kirby6365/voltra_ring/case/renders/band_plate.png

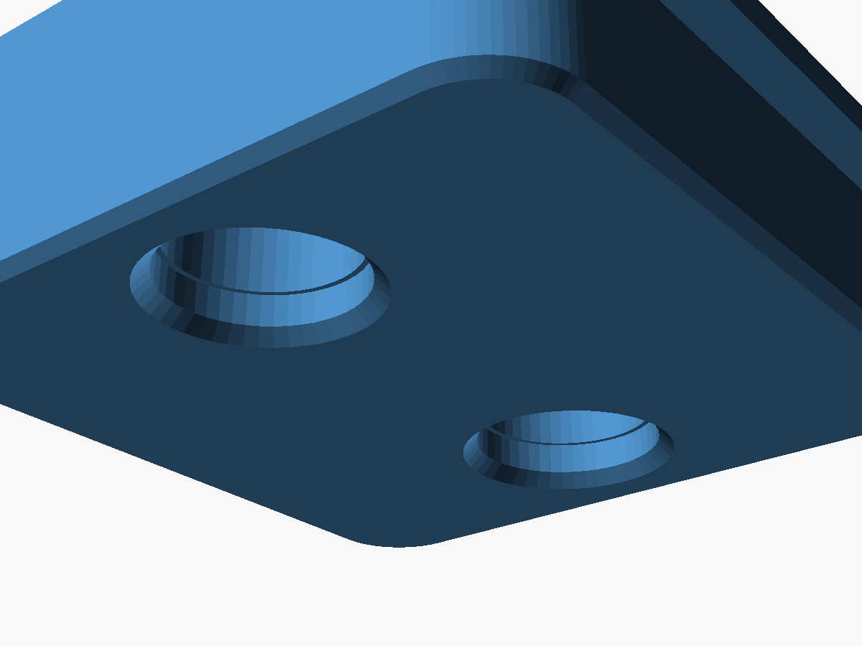
case/renders/band_plate.png
