kirby6365/voltra_ring/case/renders/clip_b_ribs.png

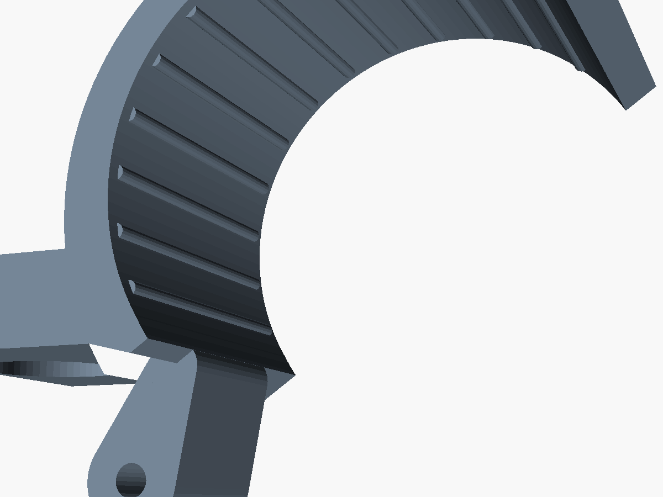
case/renders/clip_b_ribs.png
