kirby6365/voltra_ring/case/renders/clip_tpu_liners.png

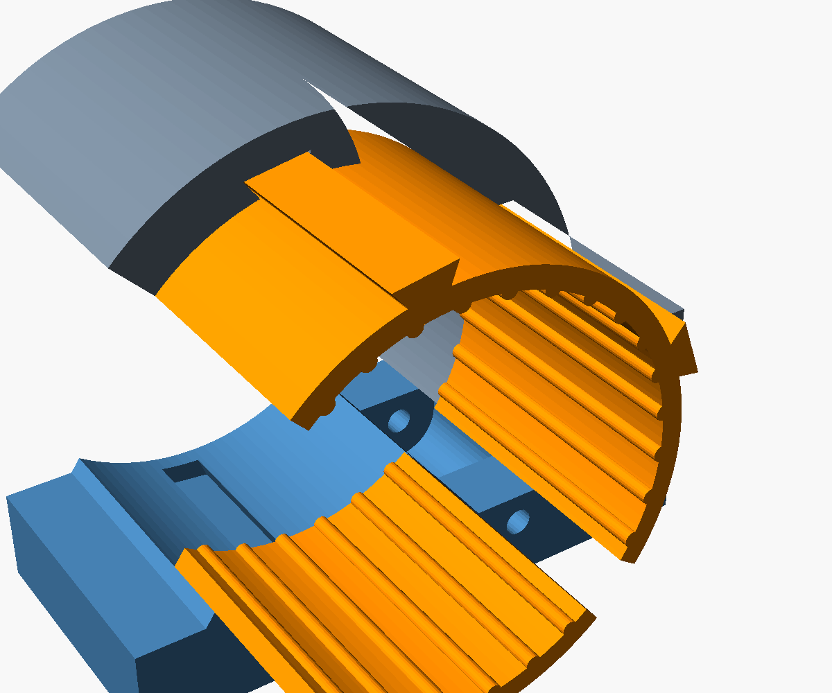
case/renders/clip_tpu_liners.png
