kirby6365/voltra_ring/case/renders/clip_tpu_side.png

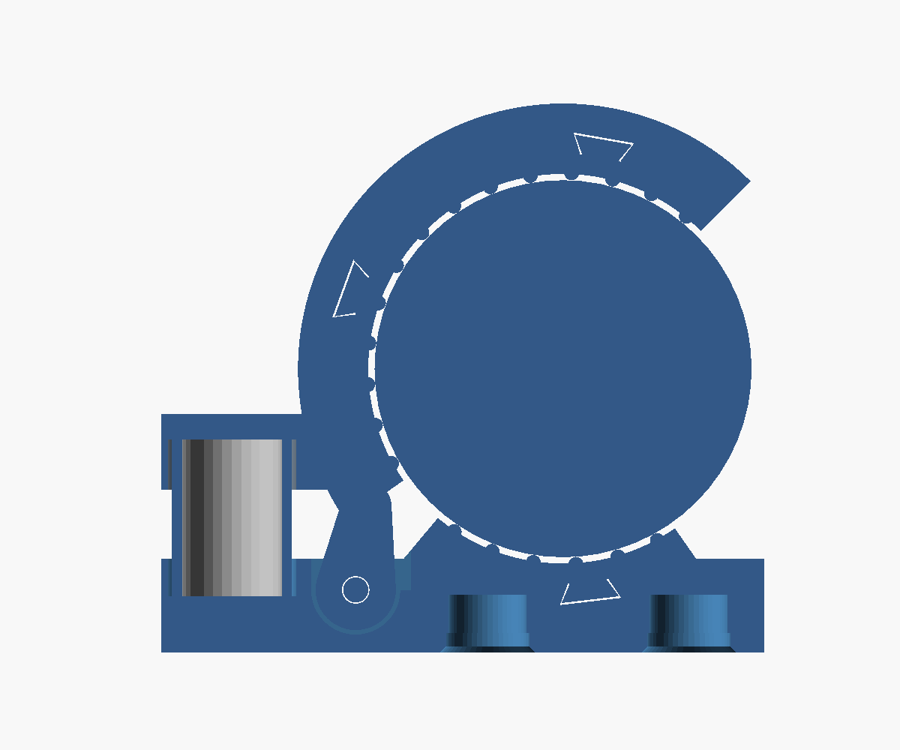
case/renders/clip_tpu_side.png
