kirby6365/voltra_ring/case/renders/clip_upper_jaw.png

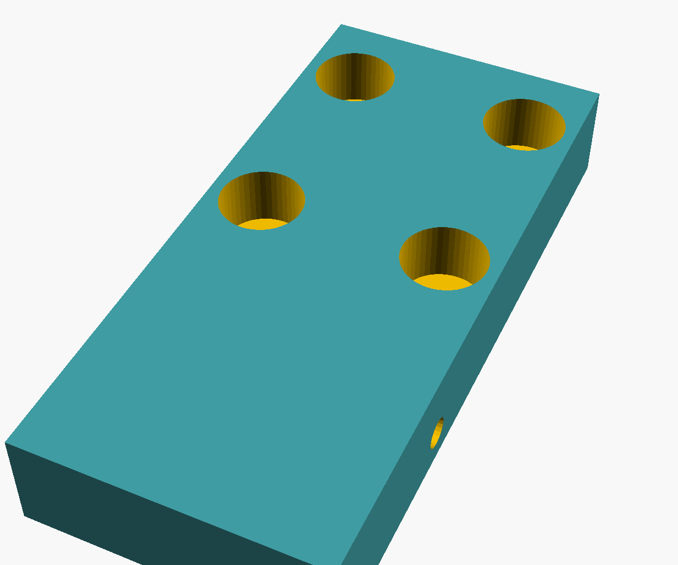
case/renders/clip_upper_jaw.png
