kirby6365/voltra_ring/case/renders/far_corner_closeup.png

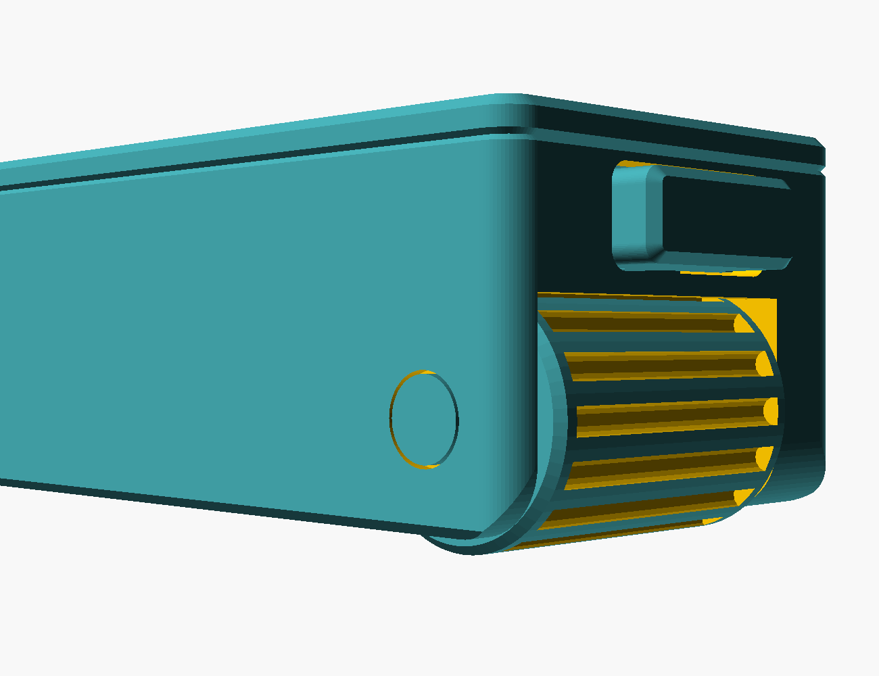
case/renders/far_corner_closeup.png
