kirby6365/voltra_ring/case/renders/lid_outside.png

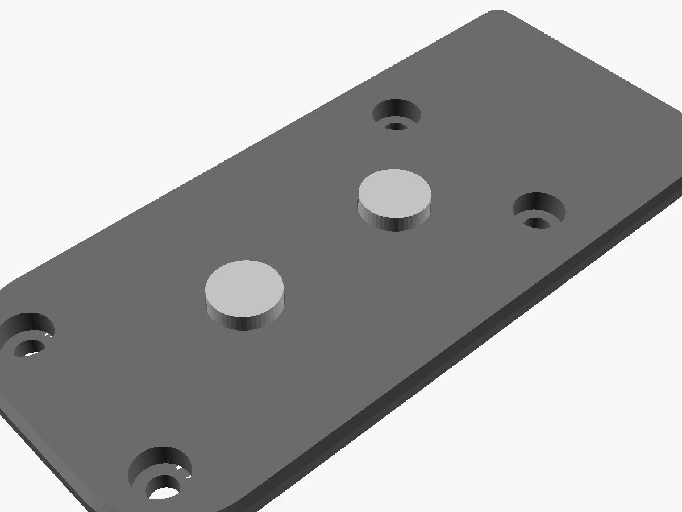
case/renders/lid_outside.png
