kirby6365/voltra_ring/case/renders/mounted_side_view.png

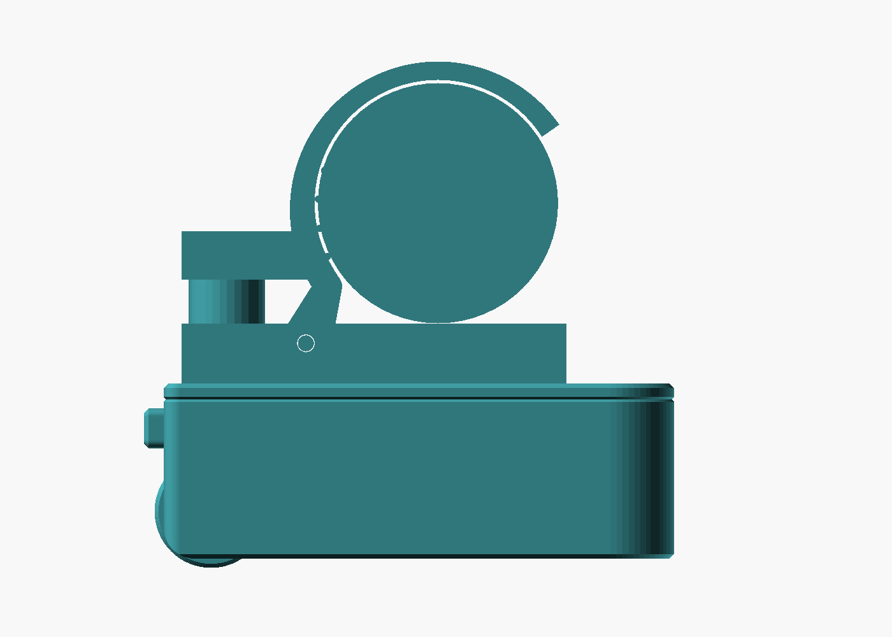
case/renders/mounted_side_view.png
