kirby6365/voltra_ring/case/renders/section.png

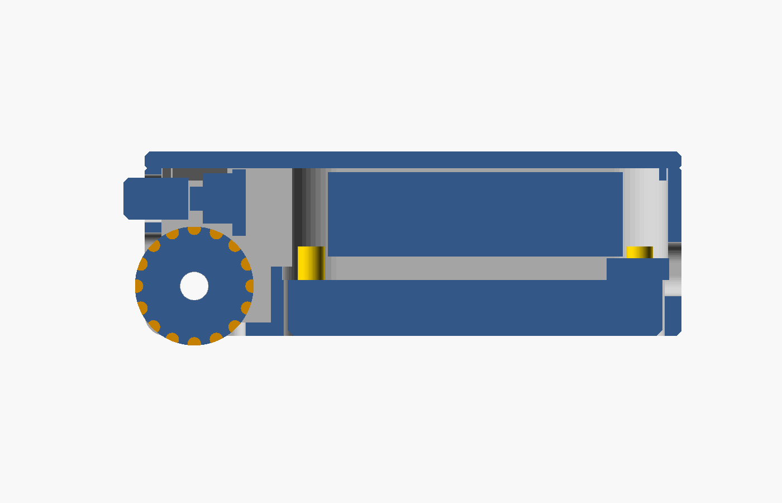
case/renders/section.png
