kirby6365/voltra_ring/case/renders/tub_far_edge.png

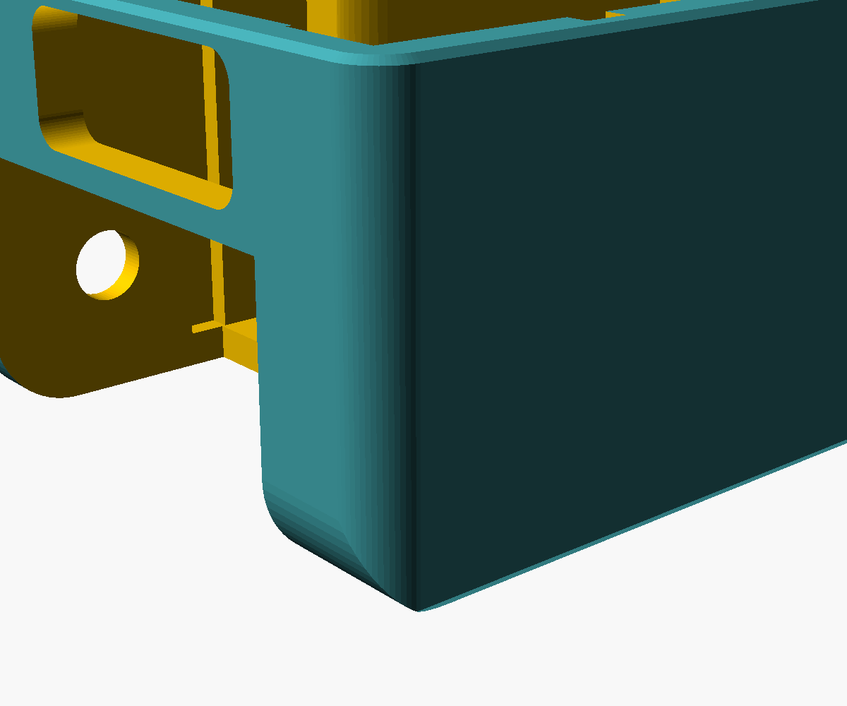
case/renders/tub_far_edge.png
