kirby6365/voltra_ring/case/renders/wheel.png

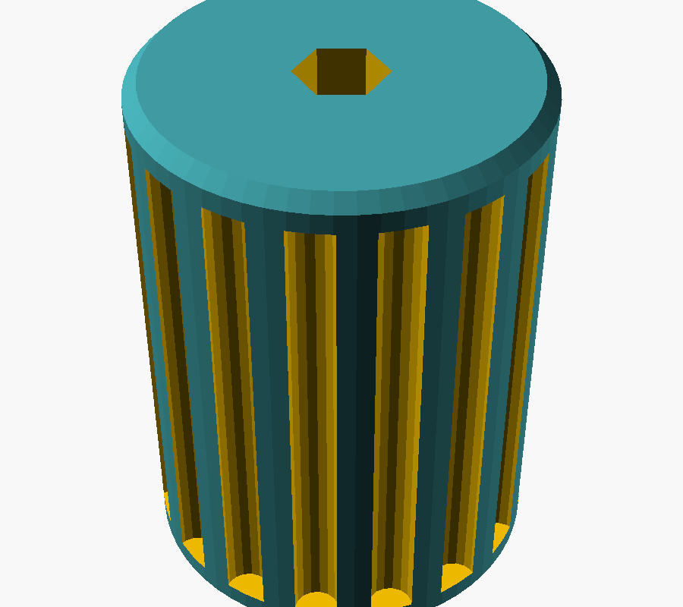
case/renders/wheel.png
