kirby6365/voltra_ring/case/renders/wheel_opening.png

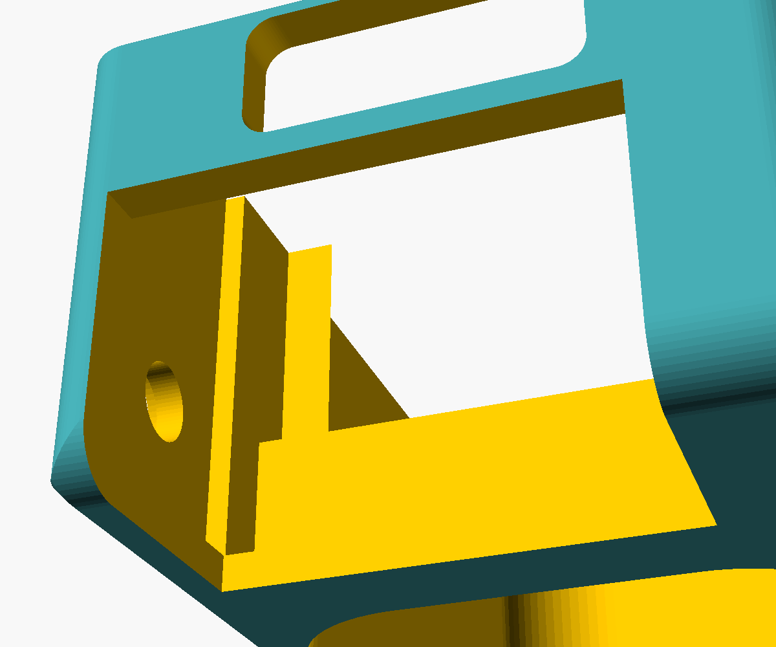
case/renders/wheel_opening.png
