kirby6365/voltra_ring/case/stl/esp32s3_lcd147_clip_b.stl

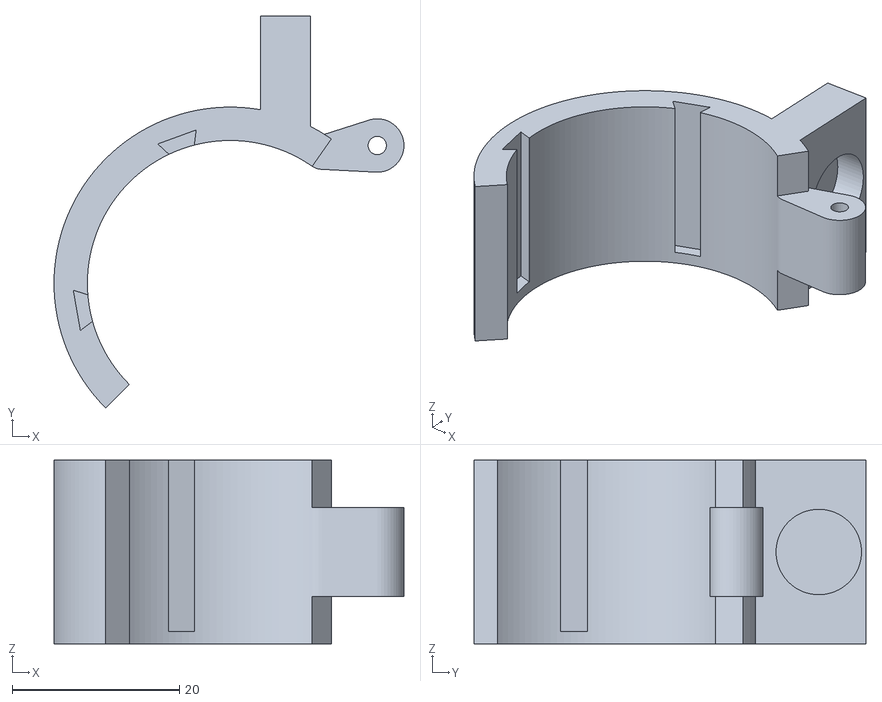
[picture p16: CAD file, 2026-11-13]
case/stl/esp32s3_lcd147_clip_b.stl
41.9 x 46.9 x 22.0
