kirby6365/voltra_ring/case/waveshare_esp32_s3_touch_lcd_1.47.STEP

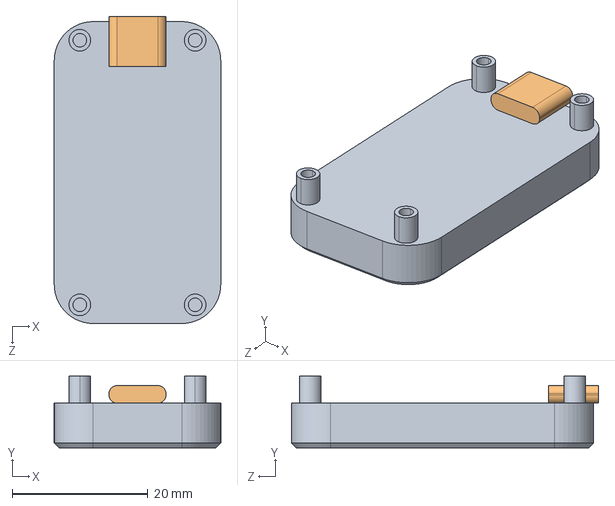
[picture p17: CAD file, 2026-11-13]
case/waveshare_esp32_s3_touch_lcd_1.47.STEP
24.6 x 10.6 x 45.2 mm
