kirby6365/voltra_ring/case/stl/esp32s3_lcd147_liner_a.stl

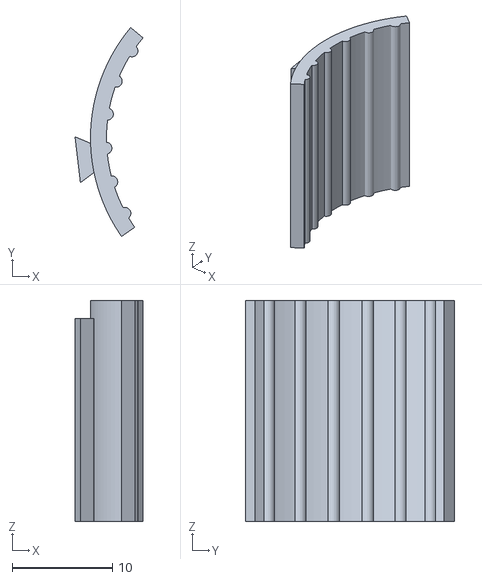
[picture p18: CAD file, 2026-11-13]
case/stl/esp32s3_lcd147_liner_a.stl
6.77 x 20.8 x 22.0
