kirby6365/voltra_ring/case/stl/esp32s3_lcd147_wheel.stl

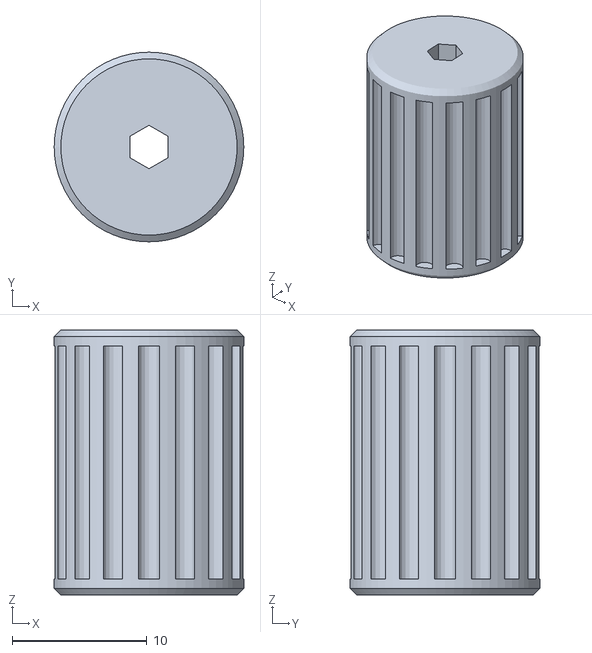
[picture p19: CAD file, 2026-11-13]
case/stl/esp32s3_lcd147_wheel.stl
14.1 x 14.1 x 19.7
