kirby6365/voltra_ring/case/stl/esp32s3_lcd147_band_20.stl

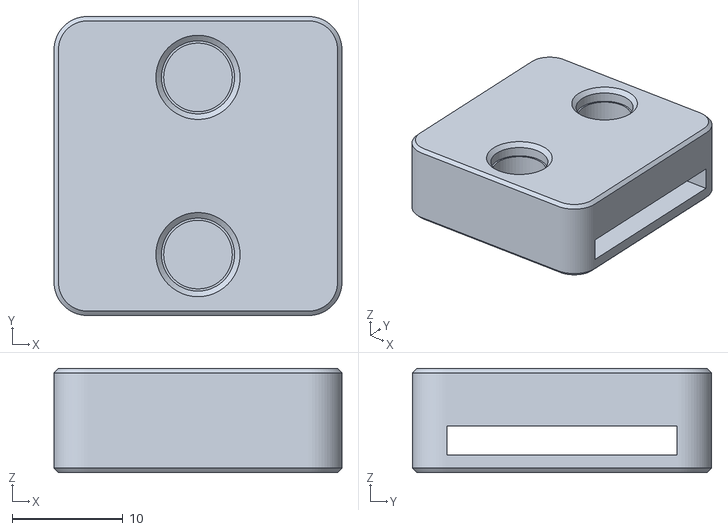
[picture p20: CAD file, 2026-11-13]
case/stl/esp32s3_lcd147_band_20.stl
26.0 x 27.0 x 9.40
