kirby6365/voltra_ring/case/stl/esp32s3_lcd147_fit_test.stl

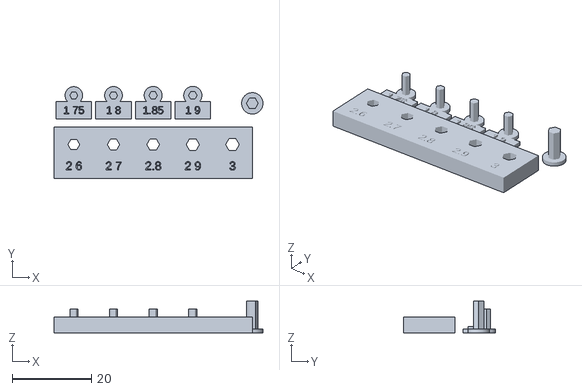
[picture p21: CAD file, 2026-11-13]
case/stl/esp32s3_lcd147_fit_test.stl
52.7 x 23.3 x 8.00
