kirby6365/voltra_ring/case/stl/esp32s3_lcd147_tub.stl

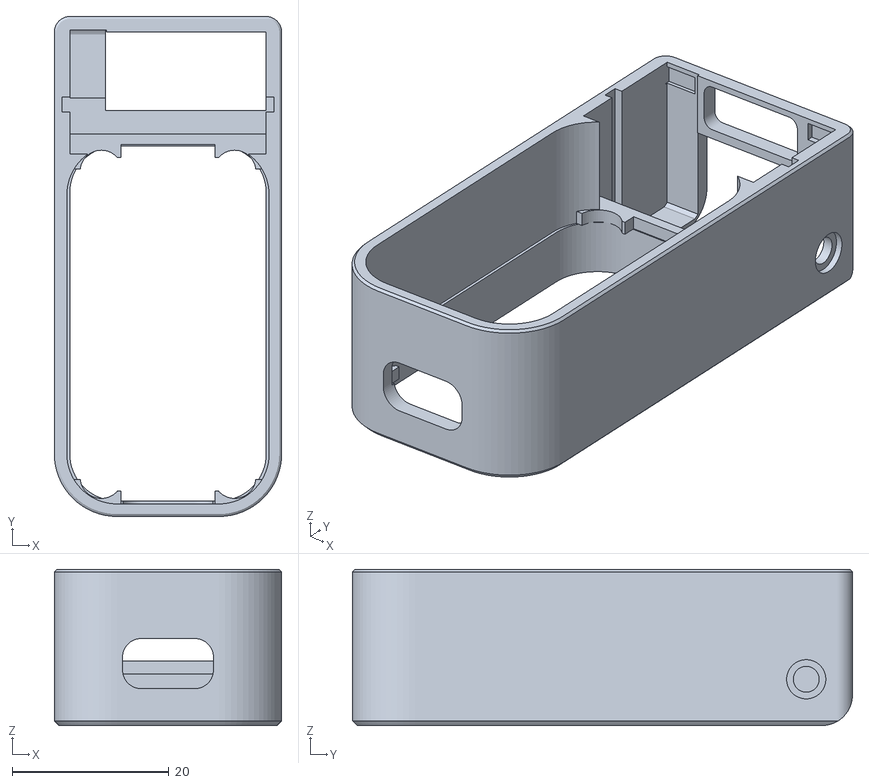
[picture p22: CAD file, 2026-11-13]
case/stl/esp32s3_lcd147_tub.stl
29.0 x 63.8 x 19.9
