kirby6365/voltra_ring/case/stl/esp32s3_lcd147_band_13.stl

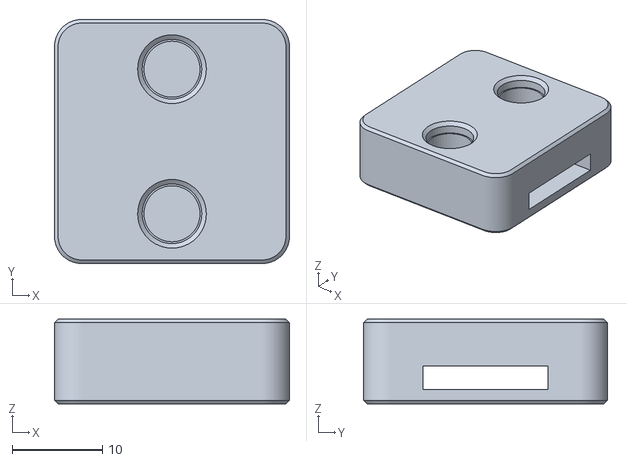
[picture p23: CAD file, 2026-11-13]
case/stl/esp32s3_lcd147_band_13.stl
26.0 x 27.0 x 9.40
