kirby6365/voltra_ring/case/stl/esp32s3_lcd147_shaft.stl

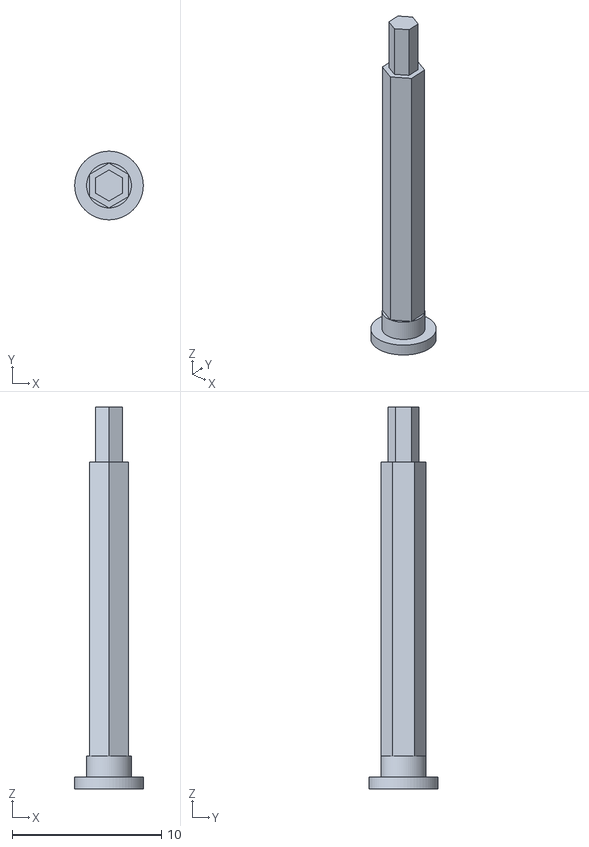
[picture p24: CAD file, 2026-11-13]
case/stl/esp32s3_lcd147_shaft.stl
4.60 x 4.60 x 25.6
