kirby6365/voltra_ring/case/stl/esp32s3_lcd147_lid.stl

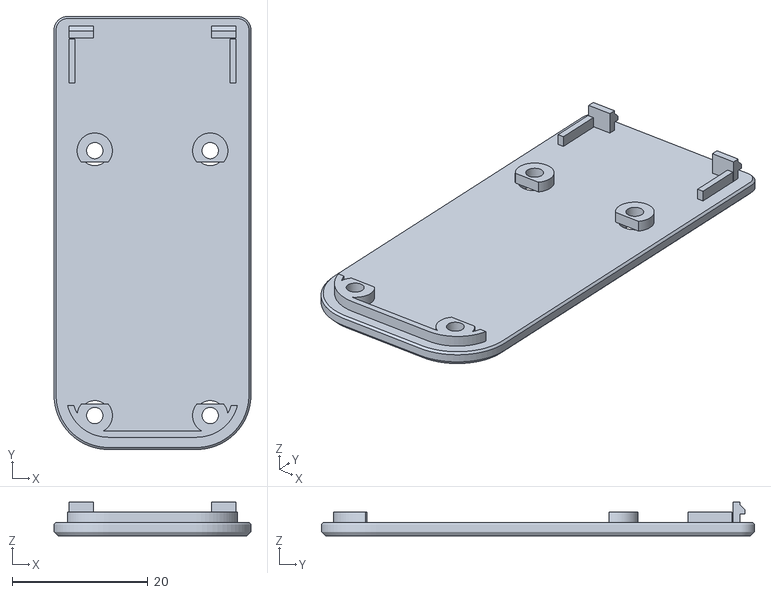
[picture p25: CAD file, 2026-11-13]
case/stl/esp32s3_lcd147_lid.stl
29.0 x 63.8 x 5.00
