kirby6365/voltra_ring/case/stl/esp32s3_lcd147_button.stl

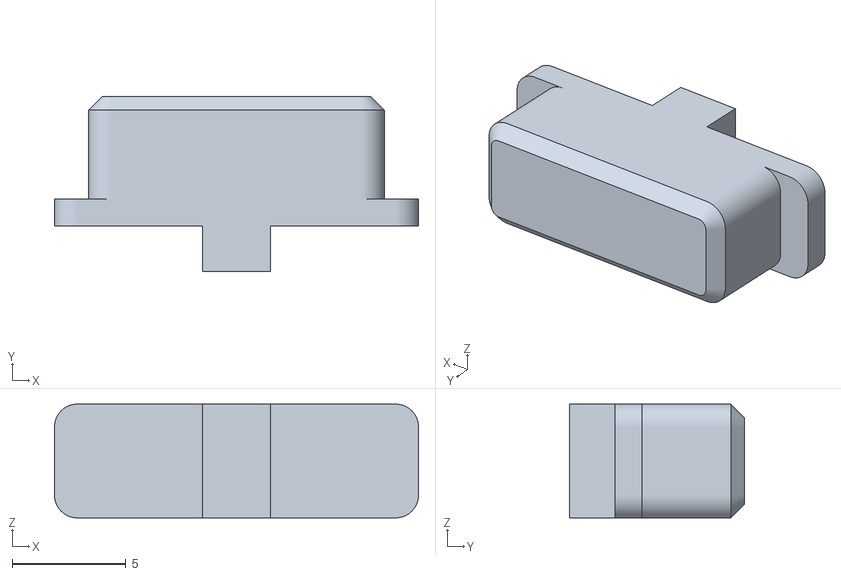
[picture p26: CAD file, 2026-11-13]
case/stl/esp32s3_lcd147_button.stl
16.0 x 7.70 x 5.00
