kirby6365/voltra_ring/case/stl/esp32s3_lcd147_fit_tips.stl

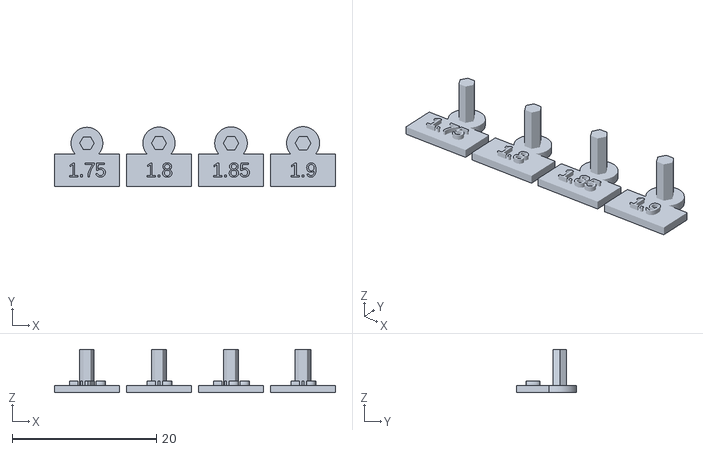
[picture p27: CAD file, 2026-11-13]
case/stl/esp32s3_lcd147_fit_tips.stl
39.0 x 8.30 x 6.00
