kirby6365/voltra_ring/case/stl/esp32s3_lcd147_liner_b.stl

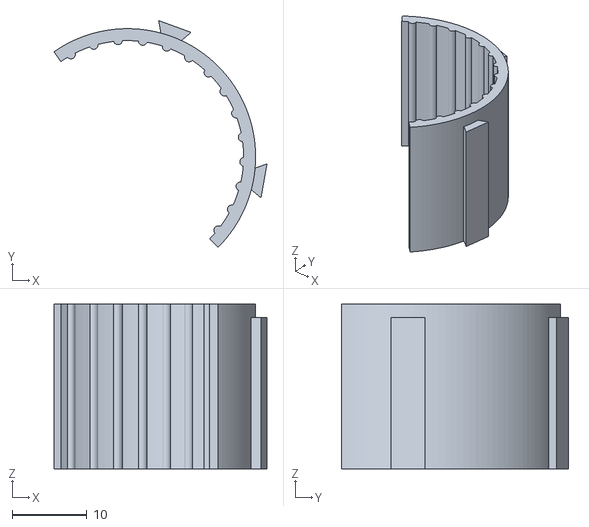
[picture p28: CAD file, 2026-11-13]
case/stl/esp32s3_lcd147_liner_b.stl
28.4 x 30.3 x 22.0
