kirby6365/voltra_ring/case/stl/esp32s3_lcd147_clip_a.stl

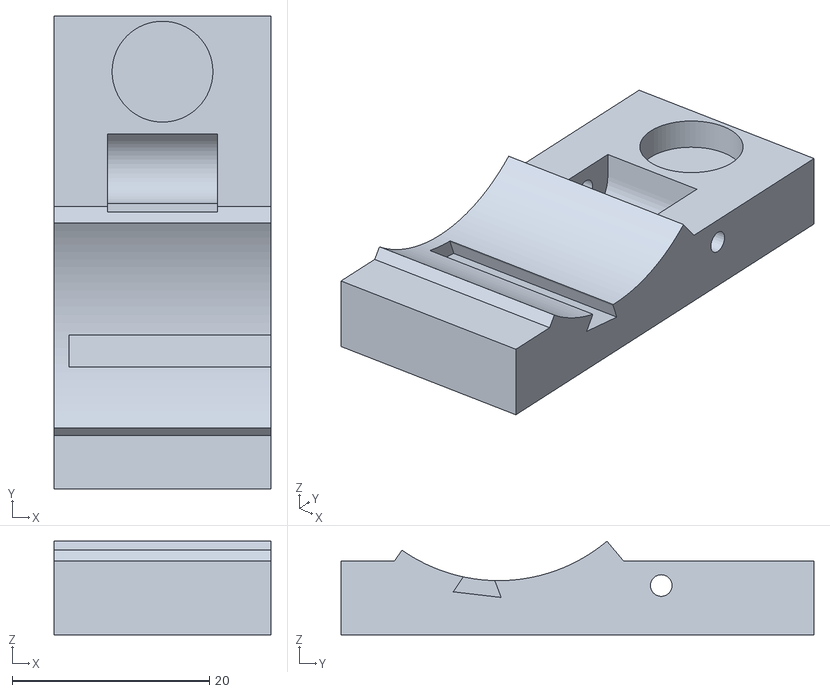
[picture p29: CAD file, 2026-11-13]
case/stl/esp32s3_lcd147_clip_a.stl
22.0 x 48.0 x 9.50
