kirby6365/voltra_ring/case/renders/assembled_front.png

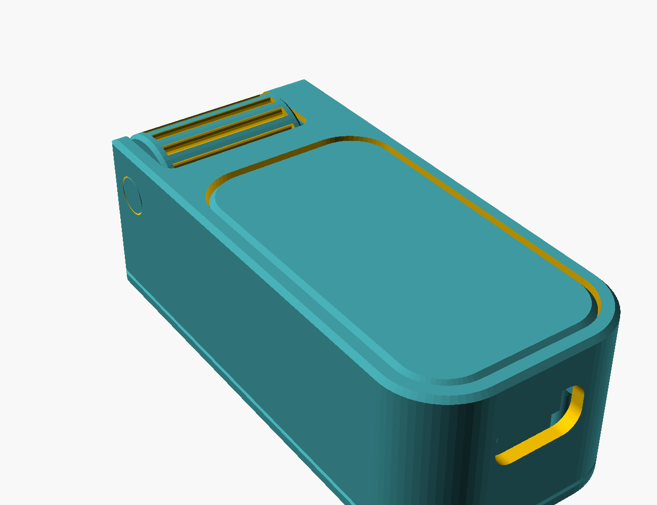
case/renders/assembled_front.png
